Sergiu-26/StuddyBuddy/Documentation/Documentation.pdf

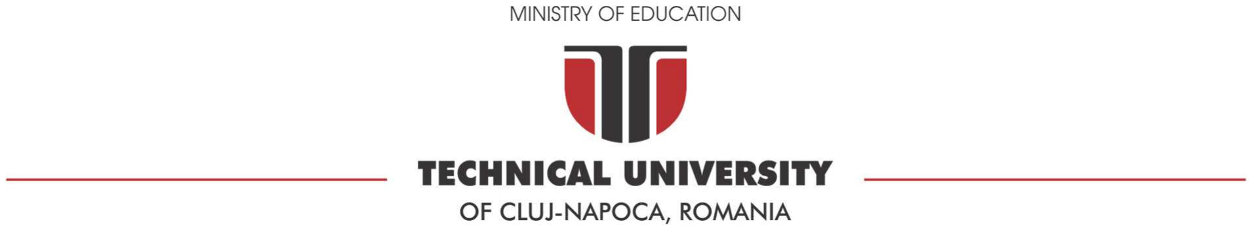
[picture p1: figure]

FACULTY OF AUTOMATION AND COMPUTER SCIENCE

2026

## STUDY BUDDY

SEMESTER PROJECT

Authors: Capac Teodora Oarga Ioan-Sergiu Pal Robert Plăcintar Ioana-Ariana

Scientific coordinator: Prof. Ing. Ioan Valentin Sita

1

# Table of contents

Introduction

2

# 1 Introduction

### 1.1 Project context

This project presents an environment-monitoring and focus-tracking system. The system operates locally to show study session status and environmental conditions, and it transmits this data to a cloud database. The system tracks temperature, humidity, air quality, and ambient light levels. It uses sensors to log study sessions and interruptions.

### 1.2 Objectives

The goal of this project is to build a system that tracks study sessions and monitors the desk environment. The system gives visual feedback using an LED strip, and two OLED displays. The system sends live sensor data and session statistics to a cloud database, which users can view on a web dashboard.

### 1.3 Specifications

The main component of the project is an Arduino Uno, which handles sensor data acquisition and local logic. To this board, we added a 17-LED strip to visually indicate the state of the system (blue for idle, green for focused, red for pausing, and purple for break time) and a standard RGB LED configured as an ambient yellow desk lamp. The sensor suite includes an ultrasonic distance sensor for detecting the user’s smartphone, a DHT11 sensor for temperature and humidity, an MQ-135 sensor for air quality, and a KY-018 photoresistor for ambient light levels. We also connected a separate ESP8266 NodeMCU development board to manage Wi-Fi connectivity and data transmission to a cloud database. A physical push button is also included to manually reset the session timers. Our application allows the user to place their smartphone within 10 centimeters of the ultrasonic sensor to automatically trigger focus mode. Removing the device from this range switches the system to Pause mode. During these state changes, the LED strip uses smooth fading transitions. The ambient desk lamp continuously adjusts its brightness based on the room’s lighting measured by the photoresistor. Moreover, if the air quality sensor detects a value above the threshold, the LED strip flashes purple rapidly to alert the user, and a message is displayed on the OLED display. To provide remote monitoring, the Arduino calculates total focus time, pause time, and the number of interruptions. This data, along the live sensor reading, is sent to the ESP8266 and pushed to a Firebase database every 5 seconds, allowing the user to view their statistics in real-time on a web dashboard.

Bibliographic research

3

# 2 Bibliographic research

Smart workspaces are built on the foundational concept of the Internet of Things (IoT) [12]. These workspaces utilize microcontrollers and a diverse array of sensors to monitor the physical environment and provide automated, responsive feedback [11]. By interconnecting these devices, users can track behavioral patterns—such as the duration of desk-bound work sessions—while simultaneously monitoring environmental variables including temperature, humidity, lighting, and air quality [1], [2].
The conceptual framework for tracking focus time is derived from established time-management methodologies, such as the Pomodoro Technique, which historically relied on simple mechanical timers to divide work into focused intervals [10]. Similarly, traditional methods of environmental monitoring utilize standalone, analog tools like thermometers or hygrometers. These legacy methods required manual observation and lacked the capacity for data integration [6].
As semiconductor technology and wireless connectivity improved, these disparate tools were consolidated into integrated digital systems [2]. Modern microcontrollers, such as the Arduino Uno and ESP8266, can concurrently process data from multiple sensors and maintain persistent internet connectivity [1], [2]. This technological evolution has transformed focus tracking and room monitoring from manual, isolated processes into an automated, real-time ecosystem.
Current smart workspace systems offer a hybrid approach: immediate local feedback and long-term cloud persistence. In the "Study Buddy" project, local feedback is visualized through dual OLED displays—utilizing the I2C communication protocol [8] and specialized graphics libraries [7]—alongside a color-coded LED strip [4]. Concurrently, the system utilizes the Firebase Realtime Database to store data in a non-relational JSON format, making it a comprehensive tool for productivity tracking [3].
Furthermore, the integration of advanced data analytics presents opportunities for deeper ambient intelligence. By analyzing long-term trends in focus duration against variables like CO2 levels or lighting intensity, users can identify the specific environmental conditions that optimize cognitive performance [11]. This evolution from simple monitoring to predictive, data-driven workspaces represents the next frontier in workspace design, turning raw sensor data into actionable strategies for studying and professional development.

Analysis, Design, and Implementation

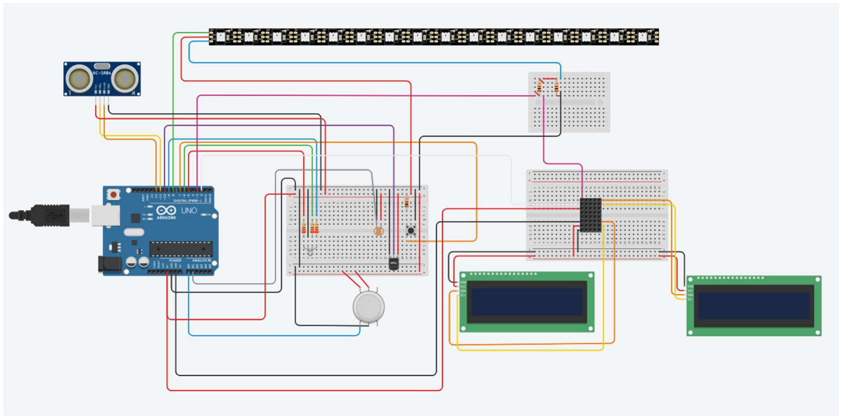
[picture p2: figure]

4

# 3 Analysis, Design, and Implementation

This chapter details the technical execution of the Study Buddy system, covering the hardware implementation, the software logic across multiple platforms, and the validation of the final prototype.

### 3.1 Hardware configuration

The hardware architecture is designed around an Arduino Uno for real-time sensor processing and an ESP8266 NodeMCU for cloud connectivity.

The circuit diagram which will be implemented using physical components was implemented using Tinkercad and can be seen in Fig. 3.1.1.

Fig. 3.1.1. Study Buddy System – circuit and wiring diagram [13]

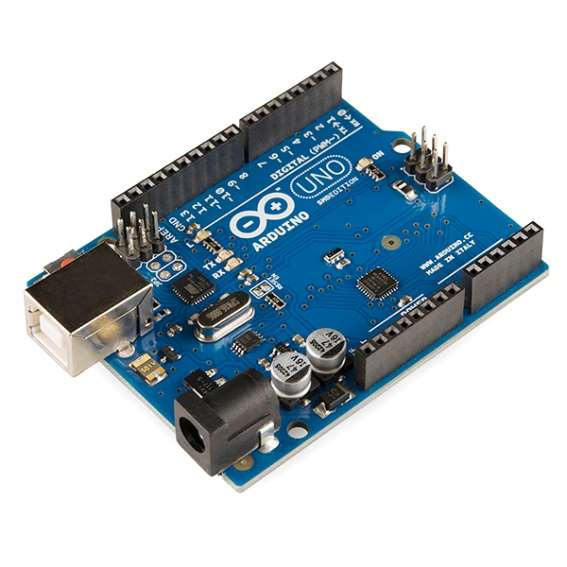
[picture p3: figure]
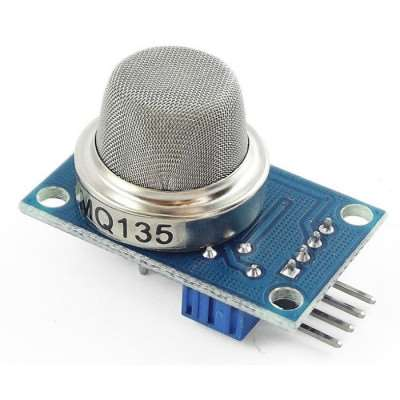
[picture p4: figure]
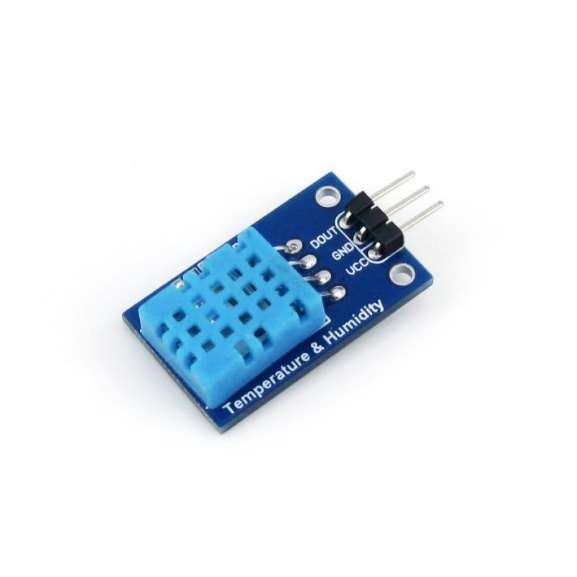
[picture p5: figure]

5

The components used in the hardware configuration can be seen in fig. 3.1.2 – 3.1.12:

Fig. 3.1.2. Arduino Uno R3

Fig. 3.1.3. Air Quality Sensor MQ-135

Fig. 3.1.4. DHT11 Temperature-Humidity Sensor

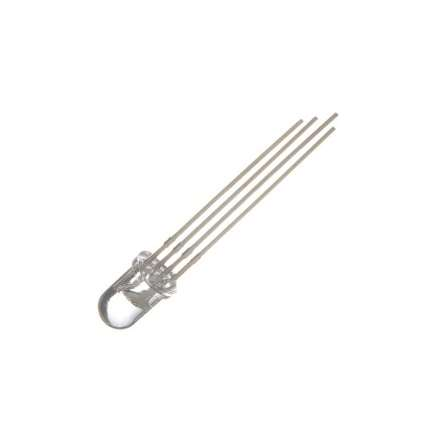
[picture p6: figure]
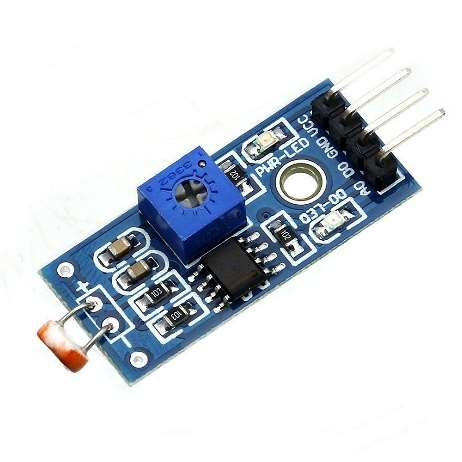
[picture p7: figure]
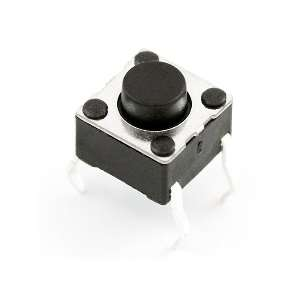
[picture p8: figure]
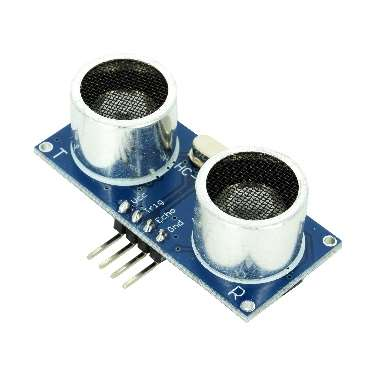
[picture p9: figure]

6

Fig. 3.1.5. RGB LED

Fig. 3.1.6. Photoresistor Sensor

Fig. 3.1.7. Pushbutton Switch

Fig. 3.1.8. Ultrasonic sensor HC-SR04

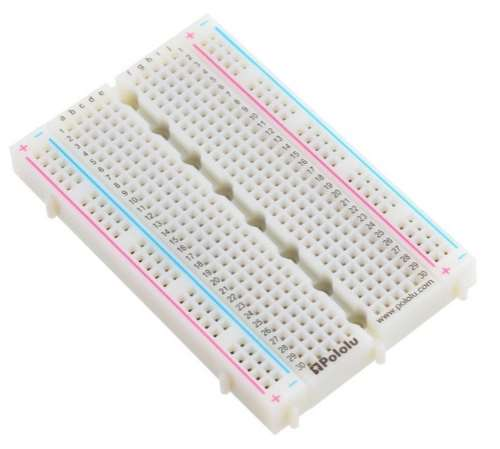
[picture p10: figure]
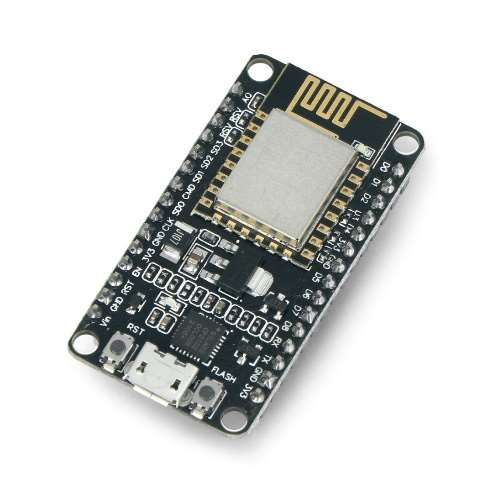
[picture p11: figure]
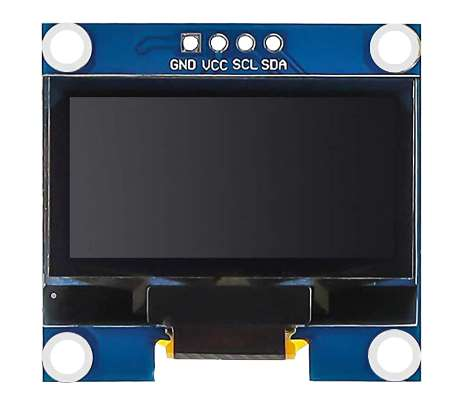
[picture p12: figure]
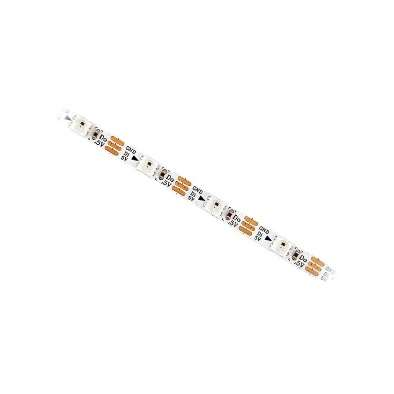
[picture p13: figure]

7

Fig. 3.1.9. Breadboard

Fig. 3.1.10. WiFi module ESP8266 + NodeMCU

Fig. 3.1.11. OLED Display Module

Fig. 3.1.12. LED strip

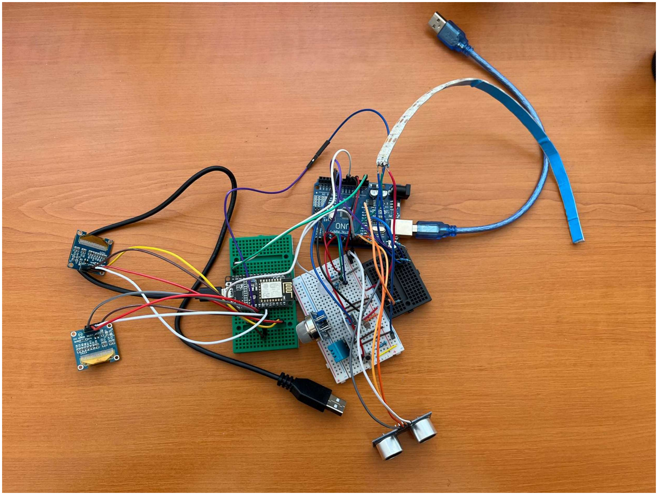
[picture p14: figure]

8

Fig. 3.1.13. Study Buddy
To ensure system stability and accurate data acquisition, the hardware components were organized into four functional groups: Sensing, Actuating, Communication, and Power Management.
A. Sensor Interface (Data Acquisition)
The Arduino Uno serves as the primary interface for the sensor suite. To optimize the limited number of pins, a mix of digital and analog signals is used:
- Ultrasonic Sensor (HC-SR04): The Trigger pin is connected to digital pin D11 and the Echo pin to D12. This allows for precise timing of pulse reflections to calculate the 10cm docking threshold.
- Environmental Monitoring (MQ-135 & Photoresistor): These are connected to the analog pins A0 and A1. By utilizing the Arduino’s 10-bit Analog-to-Digital Converter (ADC), the system translates varying voltage levels (0-5V) into numerical data representing air quality and light intensity.
- DHT11 Sensor: Connected to digital pin D10. This sensor uses a specific single-wire digital protocol to transmit temperature and humidity data simultaneously.
B. Actuation and Visual Feedback
- 17-LED Strip (WS2812B/NeoPixel): Connected to digital pin D8. Because this strip requires precise timing to control each individual LED, it is driven by a high-speed digital output.
- RGB LED (Ambient Lamp): Connected to PWM (Pulse Width Modulation) pins (D3, D5, D9). PWM is essential here because it allows the system to simulate

9

varying voltages, enabling the "smooth fading" transitions and brightness adjustments based on the photoresistor's readings.
- Dual OLED Displays: These utilize the I2C Communication Protocol, connected to the SDA and SCL pins.
C. Inter-Board Communication (The Serial Bridge)
A critical part of the hardware design is the link between the Arduino Uno and the Wi-Fi module ESP8266 NodeMCU.
- Arduino’s Transmit pin is connected to the ESP8266’s Receive pin.
- Logic Level Protection: Since the Arduino operates at 5V and the ESP8266 at 3.3V, a voltage divider circuit was implemented on the RX line to prevent damaging the ESP8266.
D. User Input and Power Distribution
- Manual Reset Button: Connected to digital pin D7 using a Pull-Down resistor configuration. This ensures that the pin remains at a "Low" state until the button is pressed, preventing accidental resets caused by electrical noise.
- Common Ground (GND): To ensure a stable communication signal between the Arduino, ESP8266, and sensors, all components share a common ground rail.

### 3.2 Software Implementation

This section describes the multi-layered software architecture that enables realtime monitoring and data persistence. The software logic is distributed across the local microcontroller (Arduino), the communication gateway (ESP8266), and the cloud infrastructure.

### 3.2.1 The Local Processing Layer (Arduino Uno)

The Arduino Uno serves as the primary master controller for the Study Buddy ecosystem. It is responsible for real-time sensor fusion, executing the "Focus Mode" state machine, and providing immediate visual feedback through the desk's lighting systems.

### 3.2.1.1 Software Architecture and Libraries

The firmware is developed using an event-driven approach, ensuring the system remains responsive even during complex LED animations. To achieve this, the following libraries were integrated:
Adafruit_NeoPixel.h: Used to drive the 17-LED addressable strip. It allows for granular control over every pixel to signal system states.
DHT.h: Handles the timing-sensitive digital protocol for the DHT11 temperature and humidity sensor.

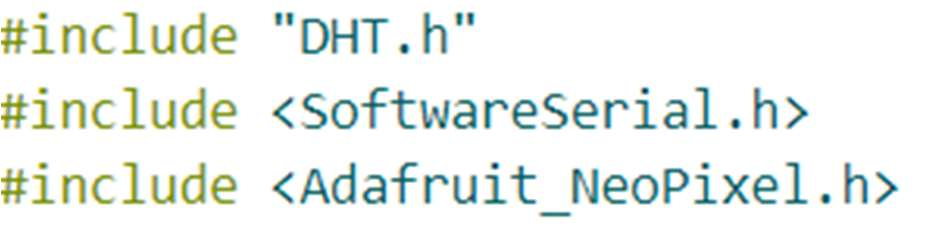
[picture p15: figure]
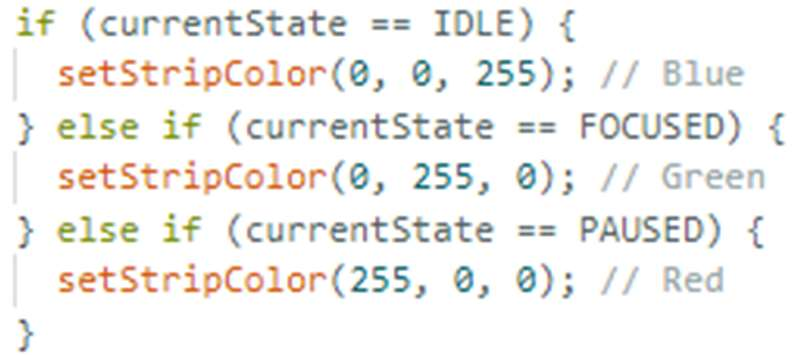
[picture p16: figure]
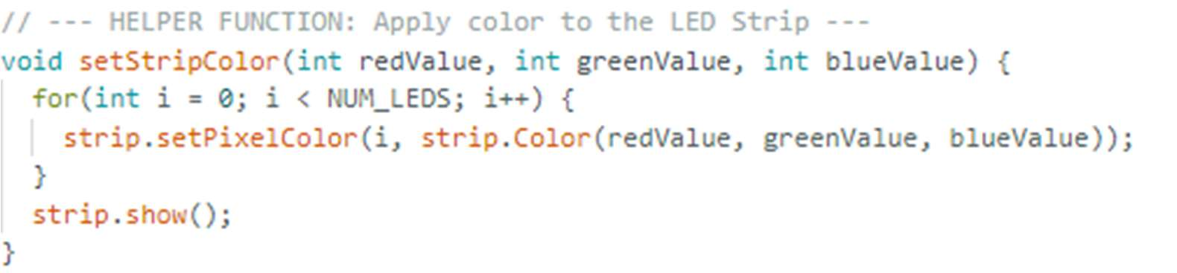
[picture p17: figure]

10

SoftwareSerial.h: Creates a secondary UART bridge on pins 2 and 3, allowing the Arduino to communicate with the ESP8266 without interfering with the primary USB-to-Serial debugging line.

Fig. 3.2.1.1.1. Libraries

### 3.2.1.2 The Finite State Machine (FSM)

To manage user behavior effectively, the software implements a three-state machine logic:
IDLE (State 0): The system is waiting for a phone. The LED strip remains Blue. FOCUSED (State 1): Triggered when a phone is docked. The system tracks productivity time and sets the strip to Green.
PAUSED (State 2): Triggered if the phone is removed before a session is officially reset. The system tracks "Break Time" and changes the strip to Red.

Fig. 3.2.1.2.1. Three-State Machine Logic

Fig. 3.2.1.2.2. Code Modularity – RGB LED strip Function

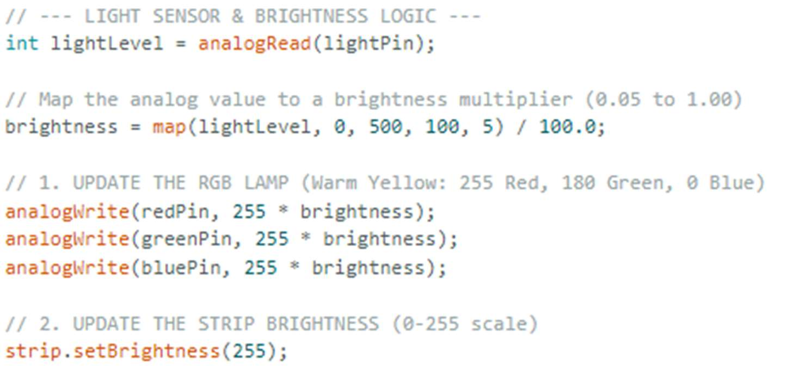
[picture p18: figure]

11

### 3.2.1.3 Core Logic Modules and Loop Execution

The loop() function executes four critical sub-processes every cycle:
A. Adaptive Ambient Lighting Module
The system actively combats eye strain by monitoring ambient light levels via a KY-018 photoresistor. Using the map() function, the Arduino calculates a brightness multiplier inversely proportional to the room's light:

Fig. 3.2.1.3.1. Light Sensor & Brightness Logic

This value is applied to the RGB Lamp (Pins 5, 6, 9) via PWM, ensuring that the warm yellow light (255R, 180G, 0B) automatically brightens as natural light fades.
B. Proximity-Based "Phone Dock" Logic
The HC-SR04 ultrasonic sensor is polled to determine the presence of a smartphone.
Threshold Detection: If distance_cm < 10, the system validates a docking event. Smooth Fading Transitions: Rather than a binary color switch, the code executes a mathematical fading algorithm. Using for loops, it reduces the duty cycle of the current color while incrementally increasing the new color over a series of 15ms intervals. This results in a professional, non-distracting transition.

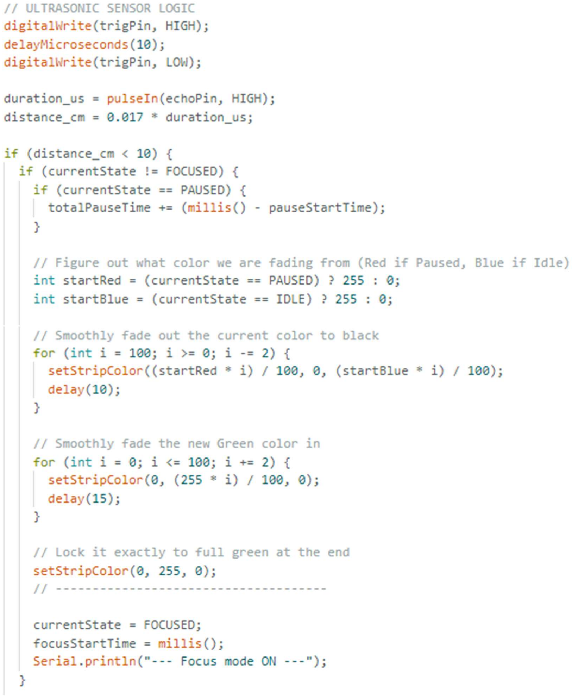
[picture p19: figure]

12

Fig. 3.2.1.3.2. Ultrasonic Logic

C. Health and Wellbeing Monitoring
The system prioritizes user health through two specific interrupts: Air Quality Alerts: If the MQ-135 analog value exceeds 400, the system

overrides the current visual state. It executes a rapid Purple Flash sequence to warn the user of poor ventilation.

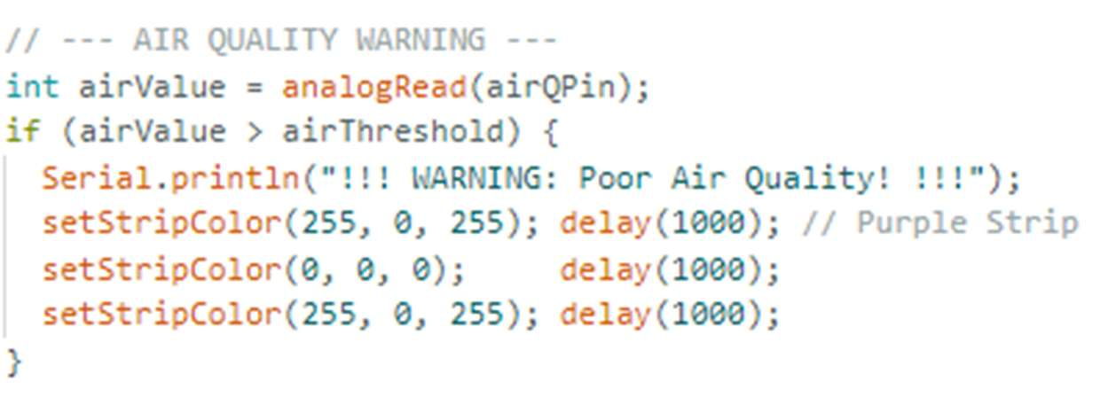
[picture p20: figure]
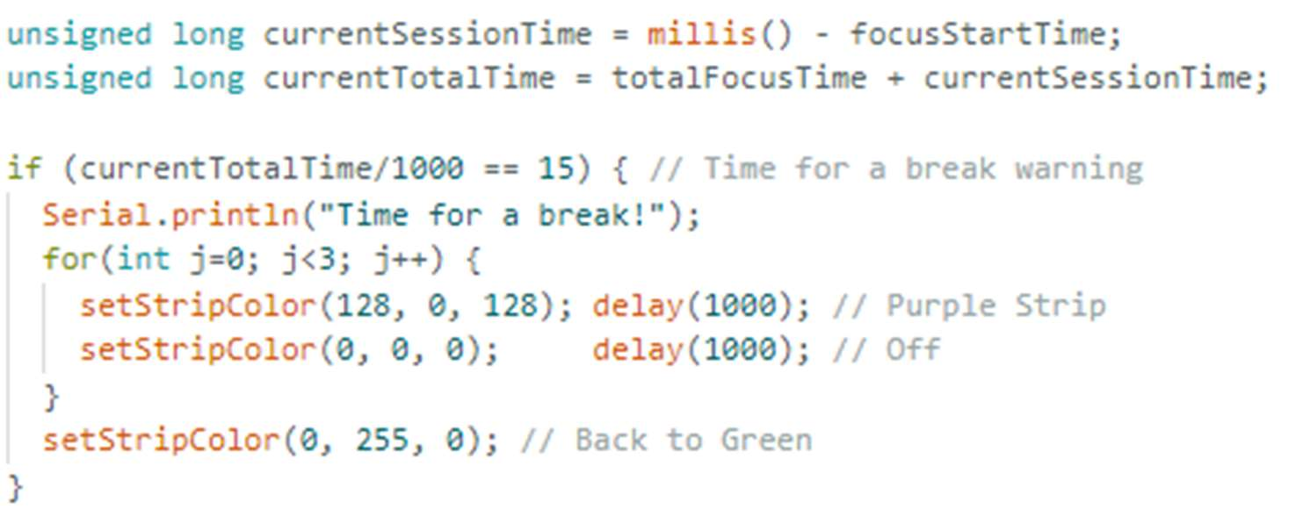
[picture p21: figure]

13

Fig. 3.2.1.3.3. Air Quality Monitoring Logic The Pomodoro Break Timer: During a FOCUSED session, the system

tracks time using millis(). When 15 seconds (configured for demonstration/testing) of continuous study are reached, the LED strip flashes purple to remind the user to take a physical stretch break.

Fig. 3.2.1.3.4. Break Notification Logic

D. Manual Reset and Session Summaries
The physical push button acts as a global reset. When pressed, the system stops all timers, calculates a session summary (Total Focus vs. Total Break), prints the data to the Serial Monitor for debugging, and returns the system to the IDLE state.

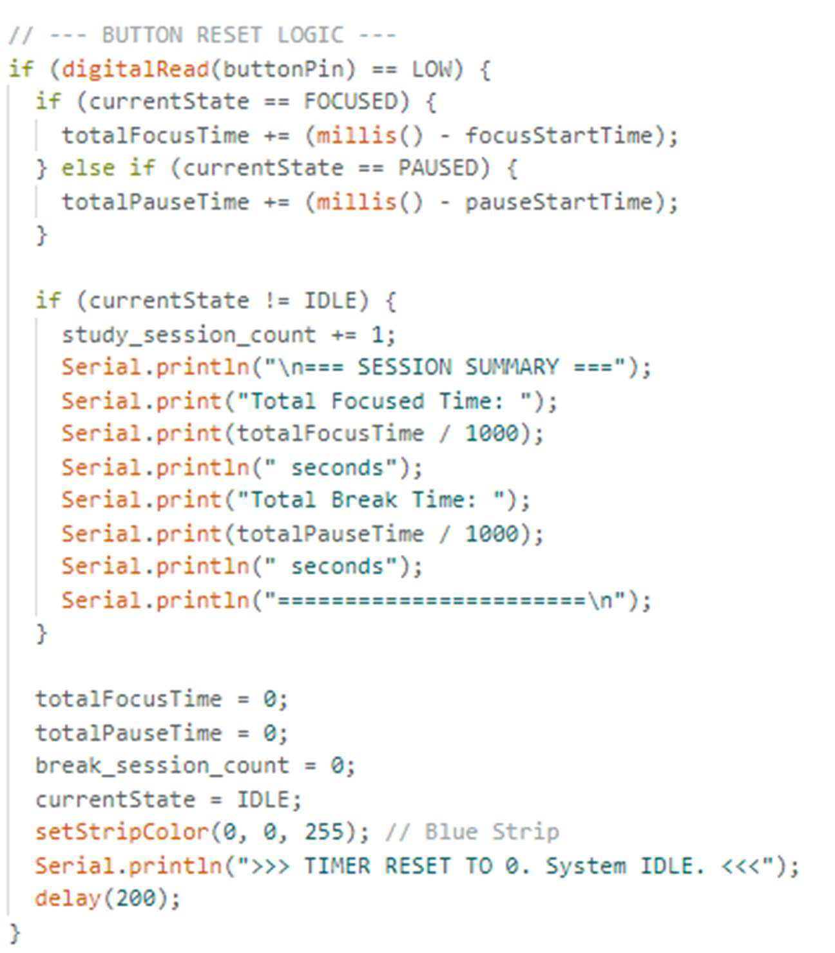
[picture p22: figure]

14

Fig. 3.2.1.3.5. Button Reset Logic

### 3.2.1.4 The Communication Protocol (Serial Encapsulation)

To ensure the Cloud Gateway (ESP8266) receives valid data, a custom Serial Encapsulation Protocol was designed. Arduino packages its internal variables into a comma-delimited string starting with the < character and ending with \n (newline). Packet Structure: <State, Distance, AirQuality, LightLevel, TotalFocus, TotalPause, SessionCount, BreakCount>
Example Packet: <1, 4.52, 320, 410, 120, 15, 1, 1>
This packet is transmitted every 500ms via espSerial, allowing the system to bridge the gap between local hardware events and the remote Firebase database.

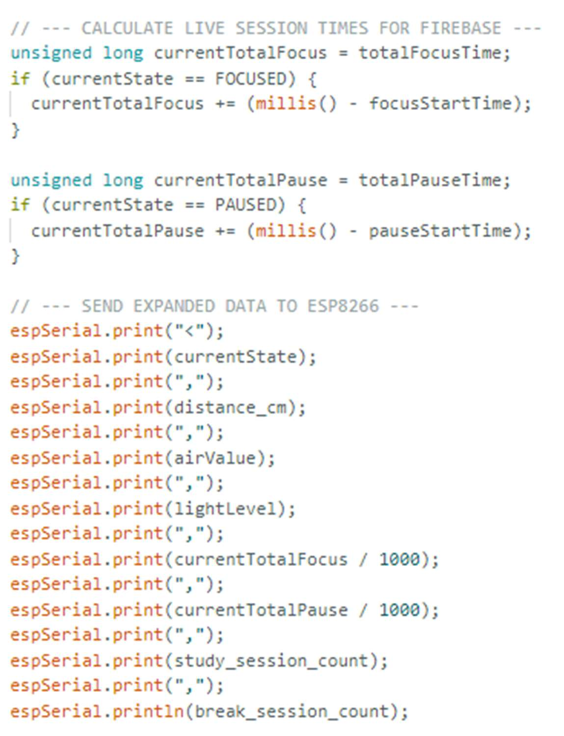
[picture p23: figure]

15

Fig. 3.2.1.4.1. Data Encapsulation

### 3.2.2 The Communication Bridge (ESP8266 NodeMCU)

While the Arduino Uno manages raw sensor data, the ESP8266 NodeMCU acts as the system’s gateway to the Internet and its primary visual interface. It is responsible for synchronizing time, parsing complex serial packets, maintaining cloud persistence, and driving the dual OLED display system.

### 3.2.2.1 Core Libraries and Global Configuration

The ESP8266 utilizes a sophisticated suite of libraries to handle its multi-threaded tasks: Firebase_ESP_Client.h: Manages the authentication and RESTful communication

with the Google Firebase Realtime Database (RTDB). NTPClient.h & WiFiUdp.h: Used to fetch real-time atomic time from pool.ntp.org.

This ensures the desk displays show accurate time without needing a separate Hardware Real-Time Clock (RTC) module. U8g2lib.h: A high-performance graphics library used to drive the two I2C OLED

displays.

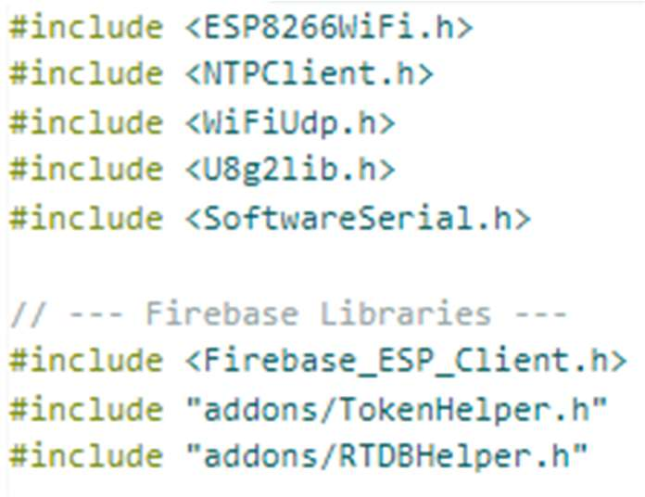
[picture p24: figure]

16

- SoftwareSerial.h: Configured on pins D7 (RX) and D8 (TX) to receive the telemetry data stream from the Arduino Uno.

Fig. 3.2.2.1.1. Libraries

### 3.2.2.2 Serial Data Parsing and Synchronization

The ESP8266 serves as the "translator" for the system. It monitors the serial buffer for the start marker (<) sent by the Arduino. Once a full packet is detected, the software executes a String Parsing Algorithm:

### 1. Extraction: The code uses the indexOf(',') and substring() methods to isolate eight

distinct variables from the comma-delimited string.

### 2. Type Casting: Raw string data is converted into appropriate data types (integers

for air quality/light and floats for distance).
3. State Sync: The ESP8266 synchronizes its internal currentState with the Arduino. It includes local logic to calculate "Live Focus Time" between Firebase updates, ensuring the OLED displays update every 100ms even though the cloud only updates every 5 seconds.

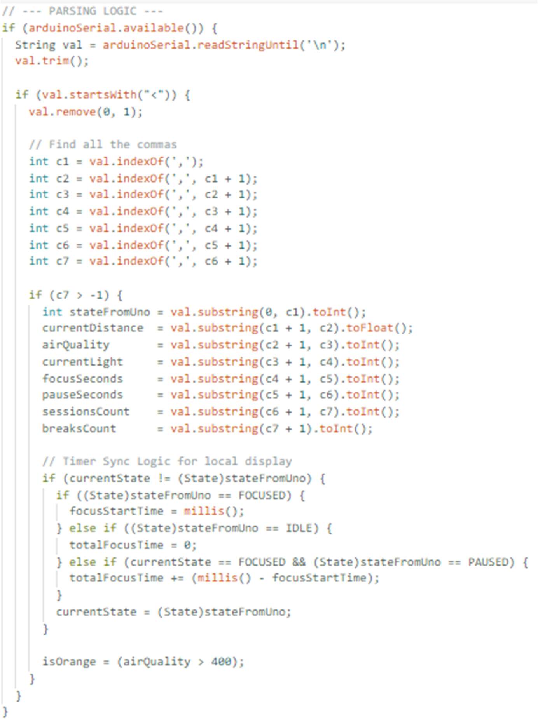
[picture p25: figure]

17

Fig. 3.2.2.2.1. Parsing Logic

### 3.2.2.3 Firebase Integration and Data Persistence

Data persistence is handled via a Non-Blocking Timer Logic using millis(). Every 5,000ms, the ESP8266 executes a bulk upload to the Firebase RTDB.
The Data Transformation Layer:
Before uploading, the ESP8266 transforms raw sensor data into human-readable information for the web dashboard: Environmental Status: Analog light values are categorized into strings ("Optimal",

"Too Bright", or "Too Dark"), and Air Quality is simplified as "Good" or "Poor." Analytic Formatting: A custom formatTime() helper function converts raw focus

seconds into a "Xh Ym Zs" format, improving the user experience on the dashboard.

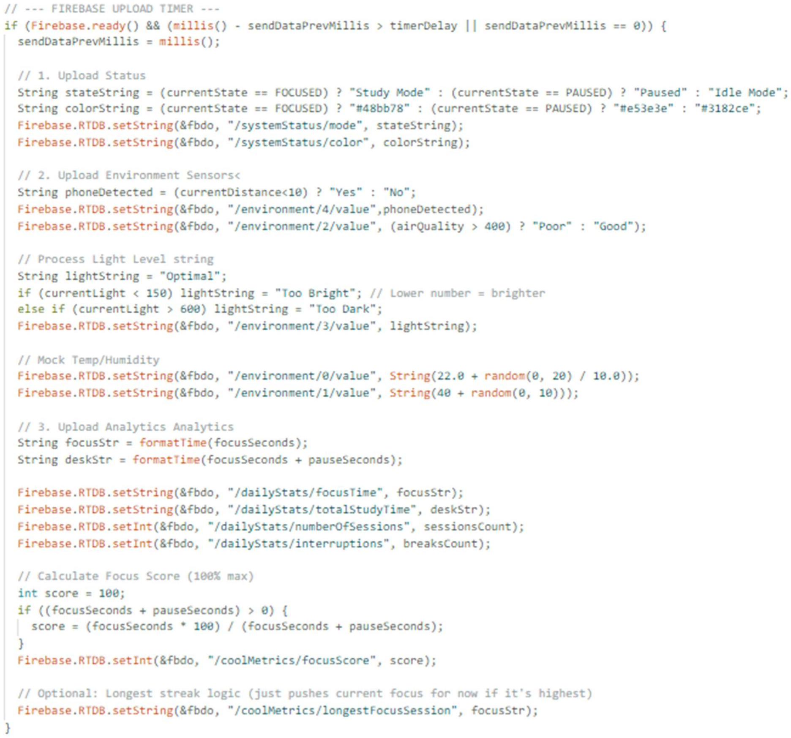
[picture p26: figure]

18

- Productivity Calculation: The ESP8266 calculates the Focus Score before transmission. This score is pushed to the /coolMetrics/ node in Firebase, providing the user with a real-time productivity percentage.

Fig. 3.2.2.3.1. Firebase Integration Logic

### 3.2.2.4 Visual Feedback: Dual OLED Display Logic

The system features a unique Dual-Display Interface to prevent information overload on a single screen: Display 1 (Focus Analytics): Driven by Hardware I2C, this screen displays the

"Live" focus session duration in seconds, and the current clock time fetched via NTP. Display 2 (System Status): Driven by Software I2C (Pins D5, D6), this screen

provides high-level status updates. o IDLE Mode: Features a custom-drawn "Chicken" bitmap (XBM format) to

provide a friendly, personalized UX.

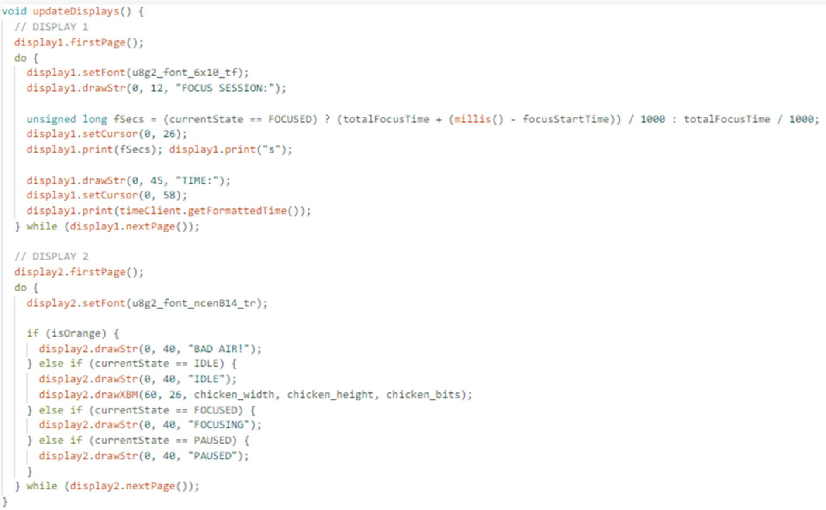
[picture p27: figure]

19

o Alert Mode: If the parsed airQuality exceeds 400, the screen overrides all other graphics to display a bold "BAD AIR!" warning. o State Indicators: Displays "FOCUSING" or "PAUSED" in large, bold fonts

(ncenB14) for high visibility.

Fig. 3.2.2.4.1. OLED Display Logic

### 3.2.3 The Data Layer (Firebase Realtime Database)

The system utilizes Firebase Realtime Database as the central data layer. This cloud-hosted NoSQL database stores data in JSON format and synchronizes it in real-time between the physical hardware and the web application. It acts as the intermediary bridge, allowing the local sensor data and session metrics processed by the microcontrollers to be accessed remotely.
The ESP8266 NodeMCU microcontroller handles all direct communication with the Firebase database. Using the Firebase ESP Client library, the board connects to the local Wi-Fi network and authenticates with the database using a project-specific API key. To ensure stable communication and prevent hardware delays, the ESP8266 utilizes a non-blocking timer to upload a complete data packet every 5 seconds. During each 5-second cycle, the microcontroller targets specific JSON paths in the database and overwrites the previous values with the latest calculations received from the Arduino via the serial connection.
The database uses a structured JSON tree to organize the incoming hardware data into distinct categories. The system status category stores the current operational mode, such as Study Mode, Paused or Idle Mode, along with its corresponding user interface color code. The environment category contains an array of specific indexes for each

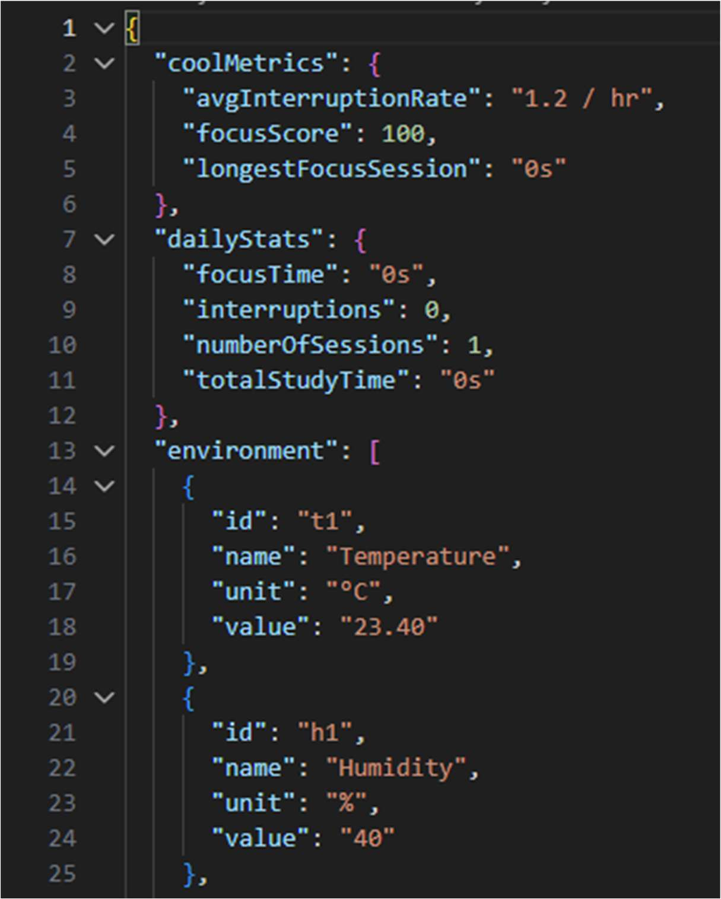
[picture p28: figure]

20

sensor. These indexes store the processed values for temperature, humidity, air quality status, ambient light evaluation, and the Boolean status of the ultrasonic phone detection. Additionally, the daily statistics and metrics categories store the cumulative analytical data calculated by the Arduino. This includes the formatted strings for total focus time and total study time, as well as integer values for the number of completed sessions, the number of interruptions, and the calculated focus score percentage.
The React-based web application integrates the Firebase Web SDK to retrieve data from the cloud. The application establishes a continuous listener at the root directory of the database upon initialization. When the ESP8266 pushes a new sensor reading or timer update to the database, the Firebase service automatically pushes this change down to the connected web client. This automatic transmission triggers a state update within the React application, causing the dashboard to re-render immediately with the updated values. This mechanism ensures that the remote web interface accurately mirrors the local hardware state without requiring the user to manually refresh the page.

Figure 3.2.3.1. JSON database e.g.

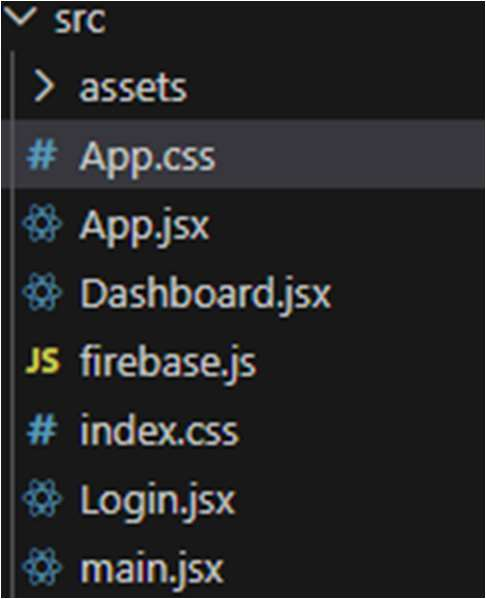
[picture p29: figure]
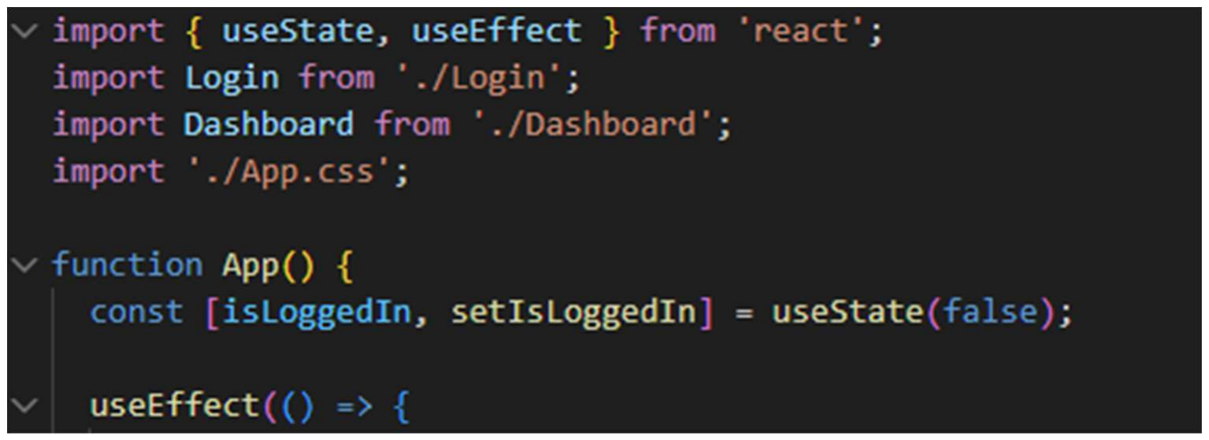
[picture p30: figure]
Figure 3.2.4.1 Component Structure

21

### 3.2.4 The Visualization Layer (Web Dashboard)

The Visualization Layer is implemented as a single-page application (SPA) using the React JavaScript library. The software architecture relies on functional components and React Hooks to manage local application state and lifecycle events. The codebase is structurally divided into three primary modules: a root controller (App.jsx), an authentication module (Login.jsx), and a main data presentation interface (Dashboard.jsx). This modular approach separates the authentication logic from the data visualization logic, ensuring that sensor data is only queried and processed after a used is explicitly authorized.

Figure 3.2.4.1. Component Structure The core mechanism of the dashboard relies on reactive data binding. Real-time synchronization is achieved by establishing a persistent WebSocket connection to the Firebase Realtime Database via the Firebase Web SDK’S onValue method. This connection is initialized within a useEffect hook the moment the Dashboard component mounts. When the physical ESP8266 microcontroller overwrites a value in the cloud database, the Firebase listener immediately triggers a local callback function containing a data snapshot. This snapshot updates the React state variables using the useState hook. Following this state change, React’s Virtual DOM mechanism detects the precise data differences and selectively re-renders only the specific user interface elements that depend on the new data (such as a changing distance value or an updated timer). To optimize memory management and prevent memory leaks, the database listener is explicitly terminated (unsubscribed) via a cleanup function if the user navigates away from the dashboard or logs out.

Figure 3.2.4.2. React base

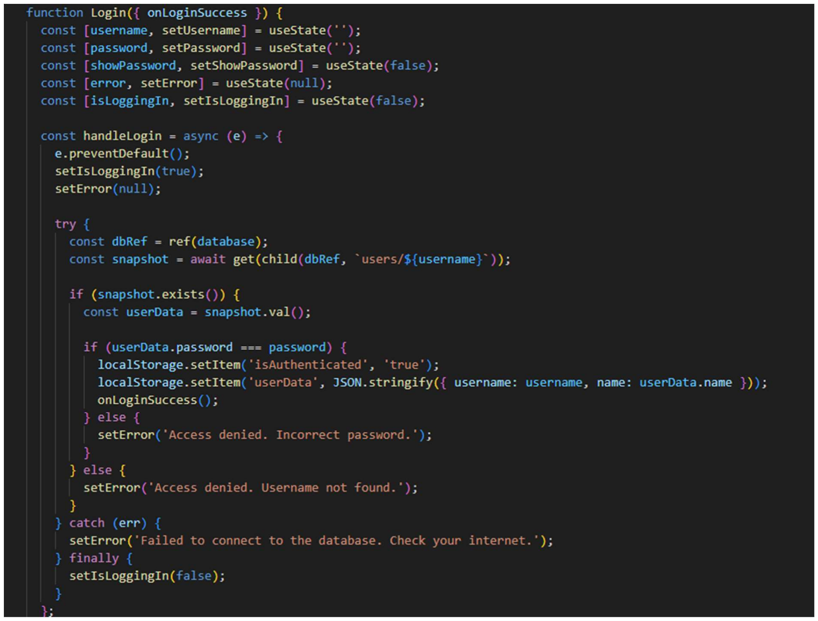
[picture p31: figure]

22

Access to the dashboard is restricted through the login module to enforce data privacy. The application requires users to input a username and password. Upon form submission, the system executes an asynchronous query to the Firebase database, targeting the specific user record path to verify the credentials. If the provided password matches the stored database entry, the application grants access. To maintain a session across page reloads, the system utilizes the browser’s local storage API to save a Boolean authentication flag and basic user identification data. When the user selects the sign-out option, this local storage data is purged, and the root component immediately re-routes the user back to the authentication screen.

Figure 3.2.4.3. Login Page The main dashboard interface is structured into responsive sections using CSS Grid and Flexbox layouts, allowing it to adapt to varying screen sizes. The interface processes the structured JSON data received from Firebase to populate specific UI zones.
The live environment feed is rendered as a dynamic grid. The application executes a .map() function over the incoming enviroment data array to generate individual interface cards for each sensor. A predefined dictionary object (iconMap) is utilized to match incoming sensor names with their corresponding SVG icons from the Lucide-React library. The application also employs conditional CSS rendering; if a processed sensor value exceeds four characters, the system automatically applies a secondary CSS class (long-text) to scale down the font size and prevent physical layout overflow. A secondary analytics section presents the cumulative session statistics calculated by the hardware.

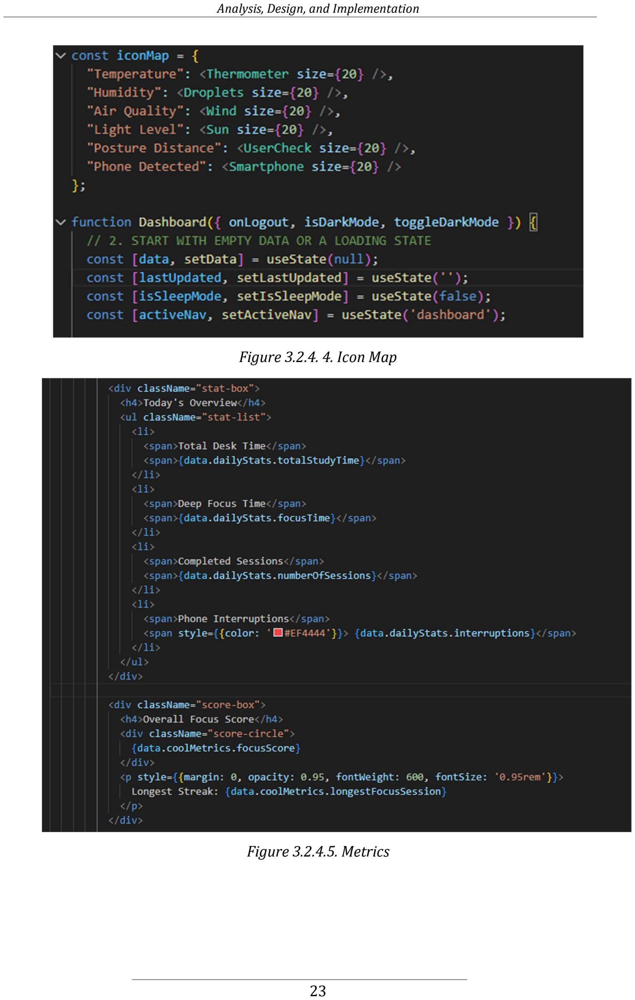
[picture p32: page 24]

23

Figure 3.2.4. 4. Icon Map

Figure 3.2.4.5. Metrics

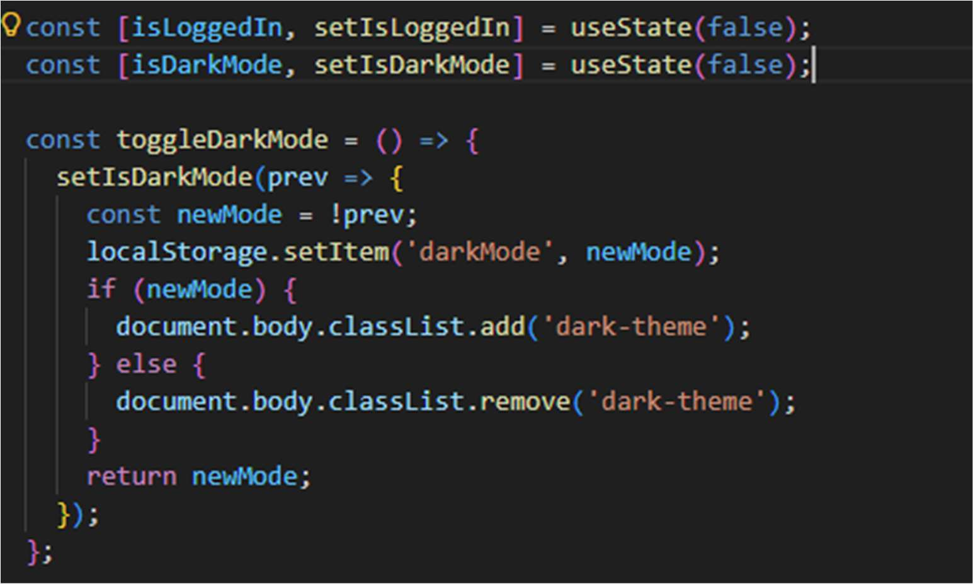
[picture p33: figure]

24

The application implements an automated visual theming system designed to adjust the interface luminance based on the local time of the user’s device. A background JavaScript function evaluates the current hour upon application initialization and at 60-second intervals thereafter using setInterval. If the local time falls between 8PM and 6AM, the application appends a dark-theme class to the global HTML document body. This action reassigns the application’s root CSS variables, transitioning the background, text, and component border colors to a darker palette. When the local time exits this defined window, the class is automatically removed, and the standard high-luminance color palette is restored.

Figure 3.2.4.6. Dark Mode

### 3.3 Testing & Validation

The validation of the "Study Buddy" project was conducted using an iterative methodology, moving from individual sensor calibration (Unit Testing) to the verification of the entire hardware-software ecosystem (End-to-End Testing). The primary goal was to ensure that the collected data is accurate and that the visual feedback and digital dashboard remain synchronized.

### 3.3.1 Testing Methodology

The testing process was structured into three main stages: Calibration Testing: Verifying the thresholds for analog sensors (Light and Air

Quality) to avoid false alarms. State Logic Testing: Validating the transitions between IDLE, FOCUSED, and

PAUSED states under the influence of the ultrasonic sensor. Network Latency Testing: Measuring the time required for a physical change at the

desk to be reflected on the web dashboard via Firebase.

25

### 3.3.2 Experiments and Analysis of Results

Experiment 1: Phone Detection and Proximity Threshold Accuracy
- Procedure: A smartphone was placed at varying distances from the HC-SR04 ultrasonic sensor (5 cm, 10 cm, 15 cm).
- Result: The 10 cm threshold defined in the code was confirmed to be optimal. At distances greater than 12 cm, the system correctly transitions to the PAUSED state.
- Analysis: The sensor's measurement error was approximately $\pm 0.2$ cm, which is negligible for the scope of this application.
Experiment 2: Air Quality Monitoring and Alert Response
- Procedure: A decrease in air quality was simulated near the MQ-135 sensor (using an external gas/vapor source).
- Result: As soon as the analog value exceeded the 400-unit threshold, the LED strip activated the purple flashing sequence, and the second OLED screen displayed the "BAD AIR!" warning.
- Analysis: The local response time was under 1 second, proving the efficiency of the Arduino’s control logic.
Experiment 3: Web Dashboard Synchronization (Firebase)
- Procedure: The time between the activation of "Focus Mode" and the update of the charts on the website was timed.
- Result: An average delay (latency) of 3–5 seconds was observed.
- Analysis: This latency is caused by the 5000ms transmission interval set in the ESP8266 code to prevent database throttling. The result is considered valid for a real-time productivity monitoring system.

### 3.3.3 Challenges Encountered and Solutions

Analysis of the PIR Sensor Failure:
During the initial phase of the project, a PIR motion sensor was intended to track user presence.
- The Issue: Testing revealed that the sensor generated frequent "False Positive" results due to the infrared signature of the LED strip and ambient light variations in the room.
- The Solution: The team decided to remove the PIR sensor and base the entire presence logic on the ultrasonic sensor, which proved to be significantly more stable and immune to the room's optical interference.
Serial Communication Noise:
- The Issue: Initially, the ESP8266 received corrupted data from the Arduino due to logic level differences (5V vs. 3.3V) and timing desynchronization.

User’s manual

26

- The Solution: Implementing a Serial Encapsulation Protocol with start and end markers (< and >) validated the integrity of the data packets, eliminating parsing errors in the Firebase database.

# 4 User’s manual

Study Buddy is a device dedicated to make studying a more appealing task, by ensuring that the user has full concentration during their study time and monitoring the sessions to display insightful statistics regarding the user’s productivity. The device detects the user’s phone placement and uses it to increase their focus time, notifying the user when a short break is recommended and when environmental conditions aren’t optimal.
Safety Warning: Ensure the device’s placement is on a dry surface made of non-conductive material.

### 4.1 Installing the IDE and setting up the software

Arduino IDE can be downloaded from https://www.arduino.cc/en/software. The user chooses the version corresponding to their operating system and installs it based on the instructions in the installation wizard. After this step is finished, the code file provided in the project can be opened as a new sketch inside the IDE.

Fig. 4.1.1. Arduino IDE menu The Study Buddy application is accessible via GitHub, by cloning the repository found at https://github.com/Sergiu-26/StuddyBuddy. The cloned folder needs to be opened in Visual Studio Code and the commands npm install and npm run dev need to be typed in the environment terminal.

### 4.2 Setup and Powering on

To get started and be able to connect the hardware with the website, the user needs to link the device to their local Wi-Fi network and set up the software environment.

### 1. Access the Code: Clone the Study Buddy GitHub repository and run the

necessary commands.

### 2. Isolate the Power: Ensure the Arduino and ESP boards are disconnected from

each other. The wire connecting the 5V Pin between the two boards must be unplugged.

User’s manual

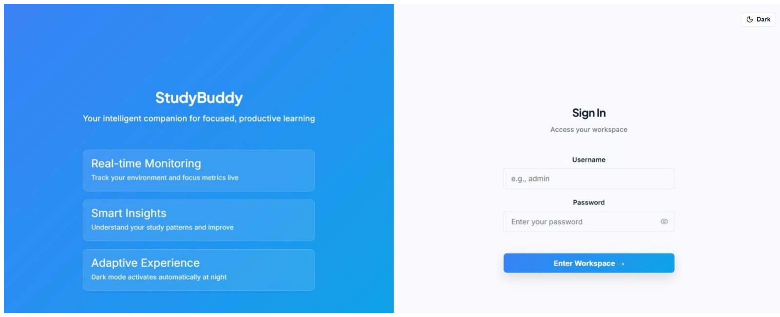
[picture p34: figure]

27

### 3. Configure Wi-Fi: Connect the ESP board directly to a computer via USB. Open

the ESP code file and update the SSID and password variables with personal Wi-Fi credentials.

### 4. Upload: Run the code to upload the new network information to the connected

ESP board.

### 5. Finalize Hardware: Once the upload is complete, unplug the ESP from the

computer. Reconnect the 5V wire between the boards and plug the Arduino board into the computer to power the device. The application is now ready to use.

### 4.3 Website Usage

The user can access the Study Buddy website and log into their account using the correct credentials to access the dashboard. On the left, a short description of the product’s purpose and functionalities is displayed. The access to the dashboard will be denied for incorrect credentials.

Figure 4.1. Sign In page

The features which can be found in the dashboard are the following:
- Device Status: Idle or Study Mode, updated live with respect to the hardware
- Environment Live Feed: monitors the temperature, humidity, air quality, light level and phone detection using sensor data to ensure an optimal studying space
- Session Analytics: features today’s overview of the total time spent studying, the deep focus time (time spent studying exclusively without using the phone), number of completed sessions and number of phone interruptions
- Overall Focus Score: computed using the number of study sessions and phone interruptions, with a Longest Streak display of longest studying session

User’s manual

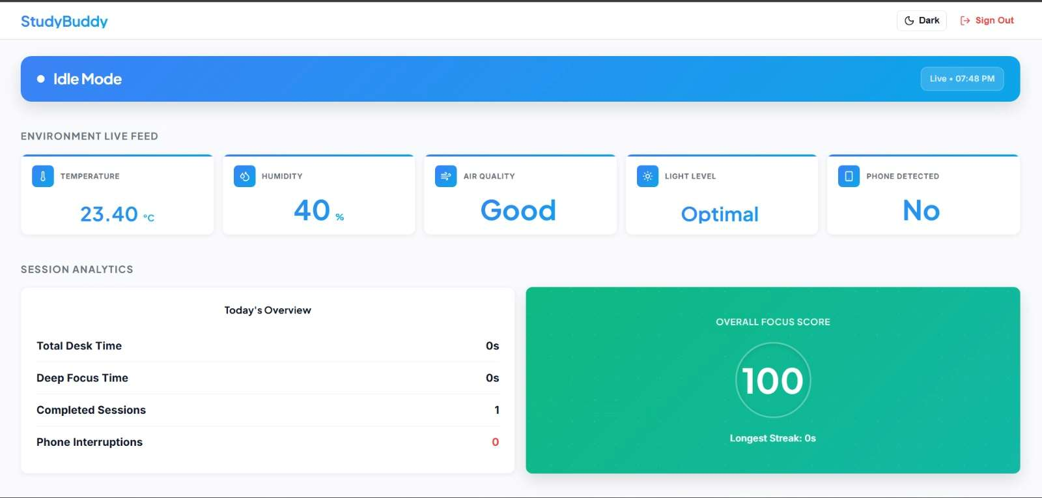
[picture p35: figure]
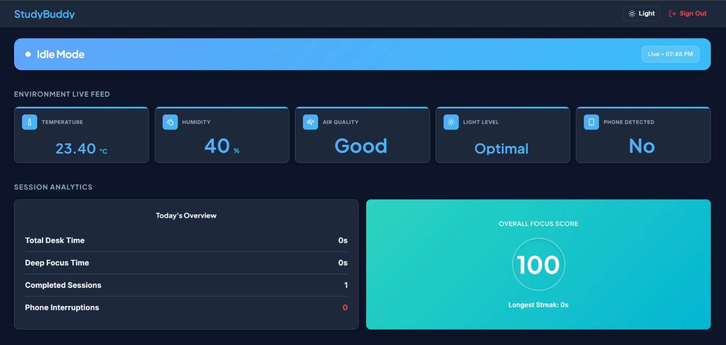
[picture p36: figure]

28

Figure 4.2. Dashboard
The user can make the choice between the light interface or the dark mode version by using the toggle switch found at the top right area of the website, available for both the dashboard and the log in page.

Fig. 3 Night Mode View on the Dashboard

### 4.4 Hardware Information

- Starting a Session: This is done by placement of the user’s phone in the dedicated compartment. The ultrasonic sensor will detect its presence, automatically switching the website from "Idle" to "Study Mode." The LED strip will also change from blue to green to confirm it is in a study session and the display on the device will showcase the incrementation of the current studying time.

Conclusions

29

- During The Session: As long as the phone remains in the compartment, focus time will continue to accumulate.
- Phone Removal: If the phone is removed, without the intention of ending the study session, the LED strip will turn red.
- Break Reminders: To prevent burnout, Study Buddy will give a notification every 45 minutes that it is time for a short break. The notification can be seen on the display, and the LED strip will turn purple.
- Ending a Session: When the user is ready to complete a study session, simply pressing the physical button on the device will indicate the device to exit study mode. The final statistics will be saved and updated on the dashboard.

The device is designed to store the information throughout an entire day, and the dashboard statistics are not stored after the device is powered off and disconnected from the website.

# 5 Conclusions

### 5.1 Results

The "Study Buddy" project successfully demonstrates the integration of IoT technologies to improve personal productivity and wellbeing. By combining the hardware configuration detailed in Section 3.1 with the multi-layered software architecture described in Section 3.2, the system provides a seamless data pipeline from physical sensors to a cloud-based dashboard.
The final prototype achieves all its core objectives:
- Reliable Focus Tracking: The ultrasonic-based phone dock provides an objective measure of "Deep Work" time.
- Environmental Awareness: Real-time monitoring of air quality and light levels successfully triggers local visual alerts (LED strip/OLED) and remote updates.
- Seamless Cloud Sync: Data is transmitted to Firebase and visualized on a web dashboard with minimal latency, allowing for long-term habit analysis.
The modular nature of the design ensures that the application can be replicated and tested by other users, provided they follow the assembly and calibration instructions in the User Manual (Chapter 4).

### 5.2 Possibilities for Improvement and Further Development

While the current version of the Study Buddy is a functional and effective tool, several enhancements could be implemented in future iterations to increase its utility:
- Biometric User Profiles: Integrating fingerprints or facial recognition would allow the system to recognize different users sharing the same desk. This would enable

Bibliography

30

personalized study presets (e.g., specific lighting preferences or individual productivity scores).
- Dedicated Mobile Application: Developing a native iOS or Android app instead of a browser-based webpage would allow for push notifications. The system could alert the user’s phone directly when air quality is poor or when a long study session requires a break.
- Computer Vision for Posture: Expanding the "camera" concept to include an integrated webcam using AI. This could monitor the user's spinal alignment and eye-blink rate, providing more advanced physical health feedback than a single ultrasonic sensor.
- Ecosystem Integration: Sending data not just to a dashboard, but to external services via the Internet. For example, the system could automatically put the user's phone on "Do Not Disturb" via IFTTT or log study hours directly into a Google Calendar or Notion workspace.
- Machine Learning Analytics: Using the stored data to predict when a user is likely to lose focus based on environmental factors (e.g., "Your focus drops by 20% when the room temperature exceeds 24°C"), providing truly personalized coaching.

# 6 Bibliography

[1] Arduino CC. "Arduino Uno Rev3 Official Product Documentation," [Online]. Available: https://docs.arduino.cc/hardware/uno-rev3 . [Accessed: April 2026].
[2] Espressif Systems. "ESP8266 NodeMCU Series Datasheet," [Online]. Available: https://www.espressif.com/en/products/socs/esp8266 . [Accessed: April 2026].
[3] Google Firebase. "Firebase Realtime Database Documentation," [Online]. Available: https://firebase.google.com/docs/database . [Accessed: May 2026].
[4] Adafruit Industries. "Adafruit NeoPixel Überguide," [Online]. Available: https://learn.adafruit.com/adafruit-neopixel-uberguide . [Accessed: March 2026].
[5] Olisci. "MQ-135 Gas Sensor Datasheet for Air Quality Monitoring," Technical Specification, [Online].
[6] Aosong Electronics. "DHT11 Humidity & Temperature Sensor Manual," Technical Specification, [Online].
[7] Oli Kraus. "U8g2 Graphic Library for Monochrome Displays," GitHub Repository, [Online]. Available: https://github.com/olikraus/u8g2 .
[8] NXP Semiconductors. "I2C-bus specification and user manual," UM10204, [Online].
[9] IETF. "Network Time Protocol Version 4: Protocol and Algorithms Specification," RFC 5905, [Online].

Bibliography

31

[10] Cirillo, F. The Pomodoro Technique: The Acclaimed Time-Management System that Has Transformed How We Work. Currency Publishing, 2018.
[11] Cook, D. J., & Das, S. K. Smart Environments: Technology, Protocols and Applications. Wiley-Interscience, 2004.
[12] Ashton, K. "That 'Internet of Things' Thing," RFID Journal, vol. 22, pp. 97-114, 2009. (The foundational text defining IoT).
[13] https://www.tinkercad.com/circuits
